openUC2/UC2-Hi2/IMAGES/Main.jpg

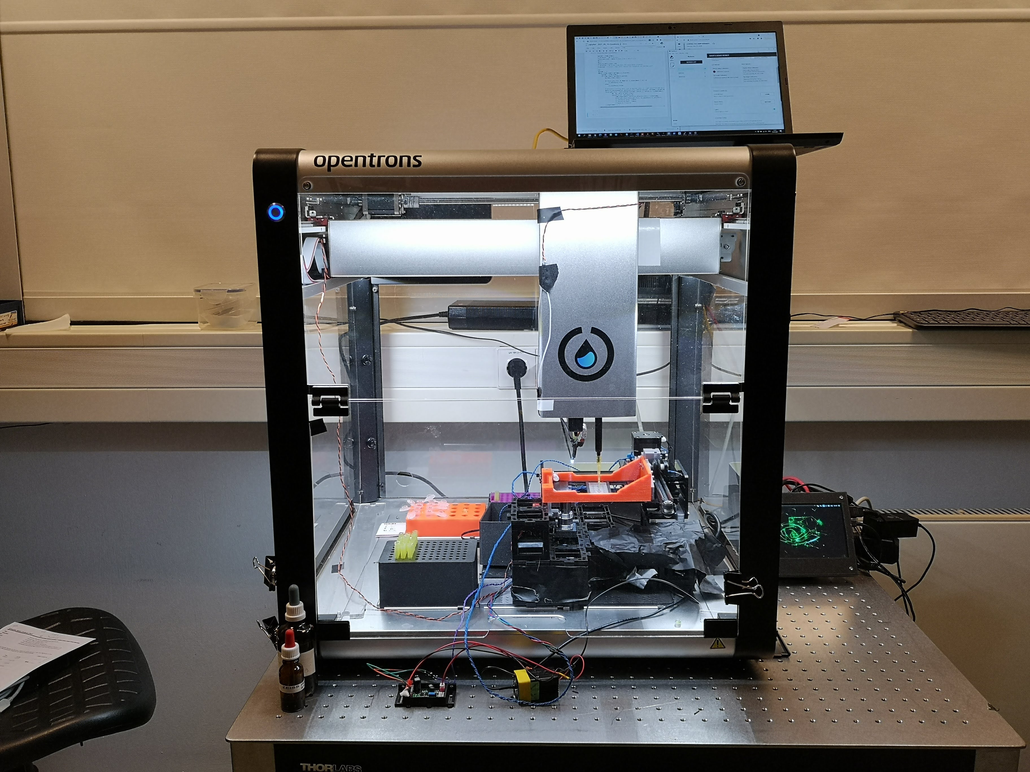
IMAGES/Main.jpg
