openUC2/UC2-Hi2/IMAGES/xyzstage.PNG

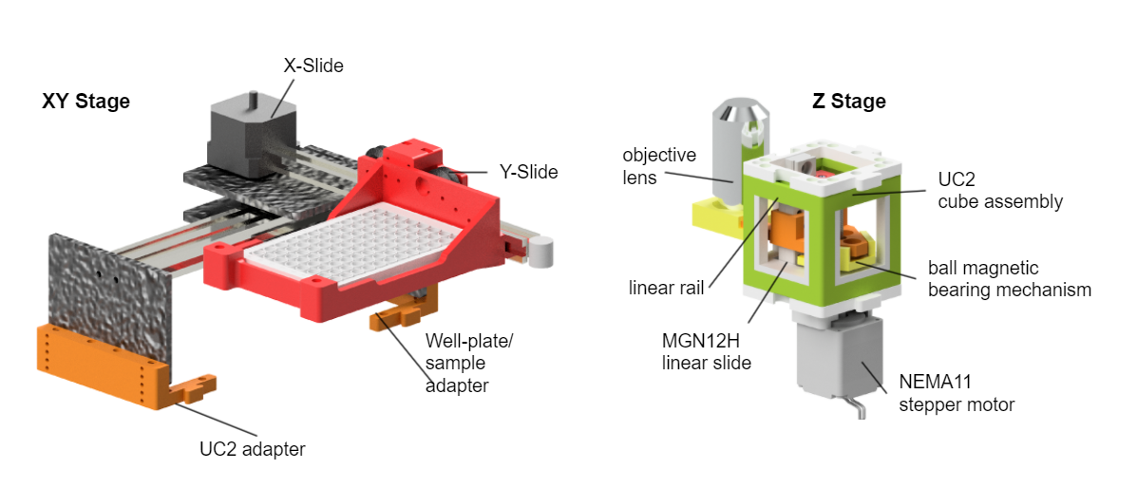
IMAGES/xyzstage.PNG
