openUC2/UC2-Hi2/UC2_Microscope_BillOfMaterial_Hi2.xlsx

Rough Price for one high-throughput microscope (without Laptop)
Shop | Name | URL | Amount | Price | Final Price
Robotershop | 4× 0,5 Meter Aluprofil 20x20 I-Typ Nut 59,40 €* (https://www.roboter-bausatz.de/p/0-5-meter-aluprofil-20x20-i-typ-nut-5) |  | 4 | 4.7 | 9.4
 | 2× Wantai Nema 17 Schrittmotor 40mm 1.7A 42BYGHW609X126,90 €* (https://www.roboter-bausatz.de/p/nema-17-schrittmotor-48mm) |  | 2 | 13 | 26
 | 1× 10 Meter GT2 Zahnriemen offen 6mm10,40 €* (https://www.roboter-bausatz.de/p/10-meter-gt2-zahnriemen-offen-6mm) |  | 1 | 5.2 | 10.4
 | 2× Riemenscheibe GT2 20 Zähne 8mm Bohrung für 6mm Riemen2,90 €* (https://www.roboter-bausatz.de/p/riemenscheibe-gt2-20-zaehne-8mm-bohrung-fuer-6mm-riemen) |  | 2 | 1.45 | 2.9
 | 6× V-Slot Führungsrolle mit Kugellager8,10 €* (https://www.roboter-bausatz.de/p/v-slot-fuehrungsrolle-mit-kugellager) |  | 6 | 4.05 | 8.1
 | 1× MKS DLC CNC / Lasergravierer Mainboard GRBL24,95 €* (https://www.roboter-bausatz.de/p/mks-dlc-cnc-lasergravierer-mainboard-grbl) |  | 1 | 12.475 | 24.95
 | 4× A4988 Schrittmotorentreiber5,00 €* (https://www.roboter-bausatz.de/p/a4988-schrittmotorentreiber) |  | 4 | 2.5 | 5
 | 1× yourDroid Netzteil 12V 3A 5,5x2,1mm DC-Stecker9,95 €* (https://www.roboter-bausatz.de/p/yourdroid-netzteil-12v-3a-5-5x2-1mm-dc-stecker) |  | 1 | 4.975 | 9.95
 | 1× Glasfaser LWL ST 12fach Pigtails farbig 9/125µ OS2 (G652.D) 1m0,99 €* (https://www.roboter-bausatz.de/p/glasfaser-lwl-st-12fach-pigtails-farbig-9-125-os2-g652.d-1m) |  | 1 | 0.5 | 1
 | 1× 50 MicroSchalter / Drucktaster 6x6x6mm0,85 €* (https://www.roboter-bausatz.de/p/50-microschalter-drucktaster-6x6x6mm) |  | 1 | 0.425 | 0.85
 | 1× 2 Pin Dupont / Jumper Kabel Buchse-Buchse 70 cm0,45 €* (https://www.roboter-bausatz.de/p/2-pin-dupont-jumper-kabel-buchse-buchse-70-cm) |  | 1 | 0.225 | 0.45
 | 1× 10er Set Befestigungsschrauben Winkel 30 I-Typ DIN 7380 M6x121,86 €* (https://www.roboter-bausatz.de/p/10er-set-befestigungsschrauben-winkel-30-i-typ-din-7380-m6x12) |  | 1 | 0.93 | 1.86
 | MGN12H Linearlager | https://www.roboter-bausatz.de/p/mgn12h-linearlager?sPartner=8 | 1 | 10 | 10
 | Linearführung MGN12H 450mm, 50mm (https://www.roboter-bausatz.de/p/linearfuehrung-mgn12h-450mm) | https://www.roboter-bausatz.de/p/linearfuehrung-mgn12h-450mm | 1 | 30 | 30
Edmund Optics | Allied Vision Alvium USB 3.1 Kamera 1800 U-158m, 1/2,9", 1,58 MP, C-Mount, monochrom (https://www.edmundoptics.de/p/allied-vision-alvium-1800-u-158m-129-158mp-c-mount-usb-31-monochrome-camera/44757/) |  | 1 | 330 | 330
 | 25,4 mm Durchm., Enhanced Aluminium, 4-6 λ Oberflächenspiegel (https://www.edmundoptics.de/p/254mm-dia-enhanced-aluminum-4-6lambda-mirror/26562/) |  | 3 | 21 | 63
 | 6mm Durchmesser x 30mm Länge, M3 Gewinde, Cage-System Stange (https://www.edmundoptics.de/p/6mm-diameter-x-30mm-length-m3-cage-support-rod/28337/) |  | 4 | 11.5 | 46
 | 25,4 mm D. x 88,9 mm Brennweite, VIS 0°-beschichtet, Achromat (https://www.edmundoptics.de/p/254mm-dia-x-889mm-fl-vis-0deg-coated-achromatic-lens/10243/) |  | 1 | 96 | 96
 | 500nm, 25mm Durchmesser, Langpassfilter OD 2 Lager #47-616 |  | 1 | 91 | 91
 | 550nm, 25mm Durchmesser, Langpassfilter OD 2 Lager #47-617 |  | 1 | 130 | 130
 | 650nm, 25mm Durchmesser, Langpassfilter OD 2 Lager #47-619 |  | 1 | 91 | 91
Optik-Pro | Optika Objektiv IOS LWD W-PLAN POL objective 20x/0.40, M-1138 | https://www.optik-pro.de/fuer-mikroskope/optika-objektiv-ios-lwd-w-plan-pol-objective-20x-0-40-m-1138/p,66005 | 0 | 168 | 0
 | Euromex Objektiv IS.7220, 20x/0.40, PLi, plan, infinity (iScope) | https://www.optik-pro.de/fuer-mikroskope/euromex-objektiv-is-7220-20x-0-40-pli-plan-infinity-iscope-/p,53372 | 0 | 159 | 0
 | Motic Objektiv CCIS plan achromat. EC-H PL 20x/0.45 (AA=0.9mm) | https://www.optik-pro.de/fuer-mikroskope/motic-objektiv-ccis-plan-achromat-ec-h-pl-20x-0-45-aa-0-9mm-/p,45909 | 0 | 169 | 0
 | Motic Objektiv EC PL, CCIS, plan, achro, NGC 20x/0.45 w.d. 1mm (BA-310 Elite) | https://www.optik-pro.de/fuer-mikroskope/motic-objektiv-ec-pl-ccis-plan-achro-ngc-20x-0-45-w-d-1mm-ba-310-elite-/p,57139 | 1 | 113 | 113
 | Windaus Objektiv 10x für HPM 100er Modelle | https://www.optik-pro.de/fuer-mikroskope/windaus-objektiv-10x-fuer-hpm-100er-modelle/p,7108 | 1 | 32 | 32
Prusa | Original Prusa Prusament PETG Galaxie Schwarz 1,75 mm 1.000 g | https://www.igo3d.com/original-prusa-prusament-petg-filament_8 | 1 | 30 | 30
Laserlands.net | 500mW RGB White Combined Laser Module Fat Beam | https://www.laserlands.net/diode-laser-module/rgb-combined-white-laser-module/11010016.html | 1 | 59.8 | 59.8
Thorlabs | F6SS088- ( Gesamtgewicht):0.01 Kgs, Fine Hex Adjuster, 6-80, 0.88" Long |  | 3 | 7.54 € | 22.62
 | F6SSN1P- ( Gesamtgewicht):0.01 Kgs, Threaded Bushing, Phosphor Bronze, 6-80, 0.25" Long |  | 3 | 4.82 € | 14.46
Misc | Screws |  | 1 | 25 | 25
 | LED (Brightfield) |  | 1 | 20 | 20
UC2 | 45° Mirror |  | 1
 | 45° mirror, kinematic |  | 2
 | Camera |  | 1
 | Filtercube |  | 1
 |  |  | 1
 | Empty |  | 12
 | Cubes total |  | 18 | 15 | 270
 | Baseplates |  | 36 | 10 | 360
 | Working Hours? |  | 10 | 50 | 500
 | Missing Things |  | 1 | 200 | 200
 |  |  |  | TOTAL: | 2634.74
