openUC2/UC2-Hi2/STL/Application_UC2_Hi2_Uppsala_v3_20_Cube_Insert_Kinematic_Mirrormount_45_base_part1_129.stl

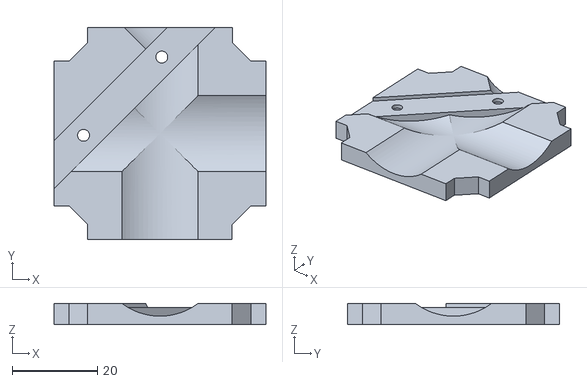
[picture p19: CAD file, 2021-12-19]
STL/Application_UC2_Hi2_Uppsala_v3_20_Cube_Insert_Kinematic_Mirrormount_45_base_part1_129.stl
49.8 x 49.8 x 5.00
