openUC2/UC2-Hi2/STL/Application_UC2_Hi2_Uppsala_v3_30_Cube_Z_Focus_Drylin_NEMA_slide_part1_70.stl

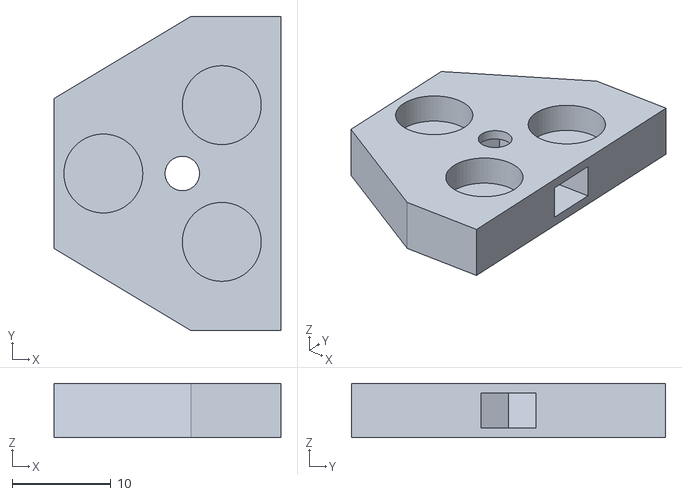
[picture p20: CAD file, 2021-12-19]
STL/Application_UC2_Hi2_Uppsala_v3_30_Cube_Z_Focus_Drylin_NEMA_slide_part1_70.stl
23.0 x 31.9 x 5.50
