openUC2/UC2-Hi2/STL/Application_UC2_Hi2_Uppsala_v3_Neje_puzzle_adapterplate_v3_21.stl

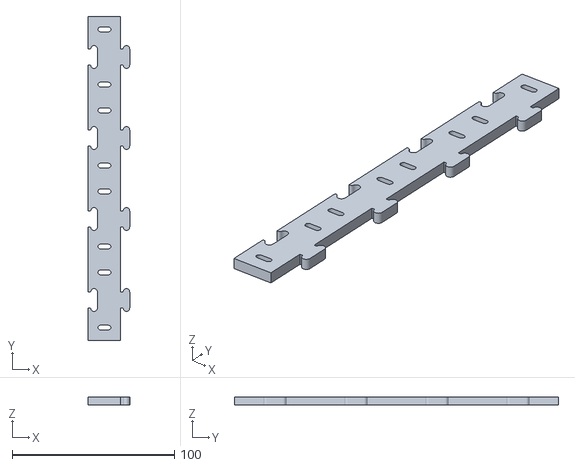
[picture p21: CAD file, 2021-12-19]
STL/Application_UC2_Hi2_Uppsala_v3_Neje_puzzle_adapterplate_v3_21.stl
25.6 x 200.0 x 5.00
