openUC2/UC2-Hi2/STL/Application_UC2_Hi2_Uppsala_v3_TOTEM_Base_Slide_y_20mmrod_7.stl

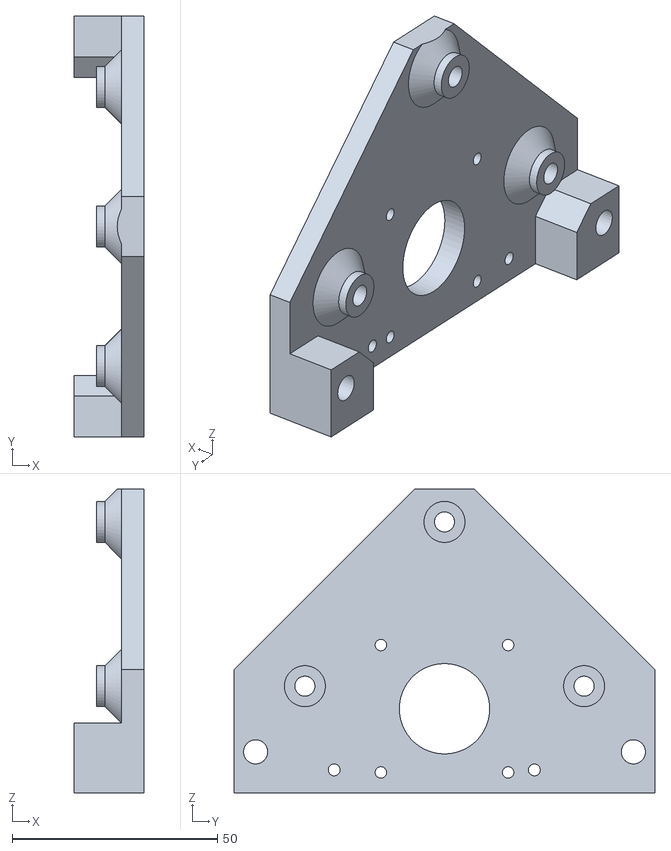
[picture p22: CAD file, 2021-12-19]
STL/Application_UC2_Hi2_Uppsala_v3_TOTEM_Base_Slide_y_20mmrod_7.stl
17.0 x 102.5 x 74.0
