openUC2/UC2-Hi2/STL/Application_UC2_Hi2_Uppsala_v3_20_Cube_Insert_Lens_165mm_36.stl

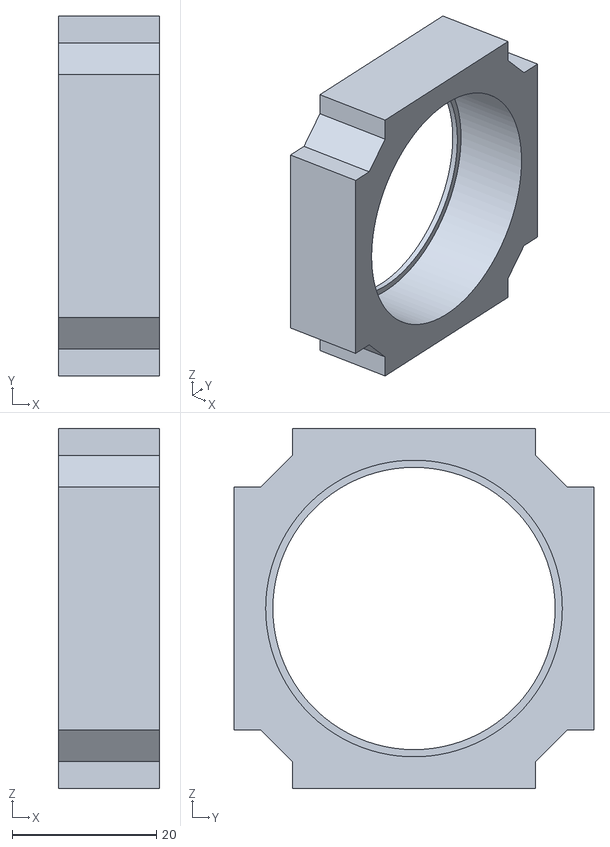
[picture p23: CAD file, 2021-12-19]
STL/Application_UC2_Hi2_Uppsala_v3_20_Cube_Insert_Lens_165mm_36.stl
14.0 x 50.0 x 50.0
