openUC2/UC2-Hi2/STL/Application_UC2_Hi2_Uppsala_v3_30_Cube_Z_Focus_MGN_NEMA_Motorsupport_73.stl

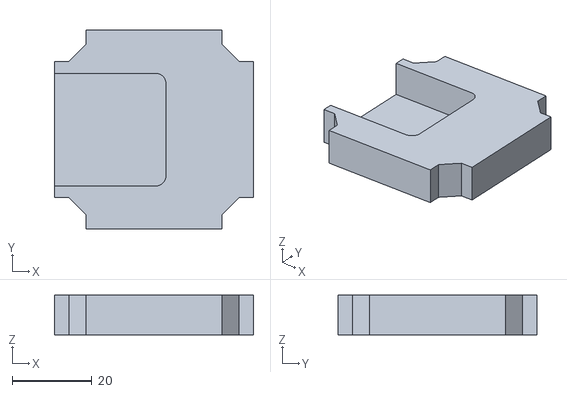
[picture p24: CAD file, 2021-12-19]
STL/Application_UC2_Hi2_Uppsala_v3_30_Cube_Z_Focus_MGN_NEMA_Motorsupport_73.stl
49.8 x 49.8 x 10.0
