openUC2/UC2-Hi2/STL/Application_UC2_Hi2_Uppsala_v3_30_Cube_Z_Focus_MGN_NEMA_Motoradapter_28BYJ_v3_72.stl

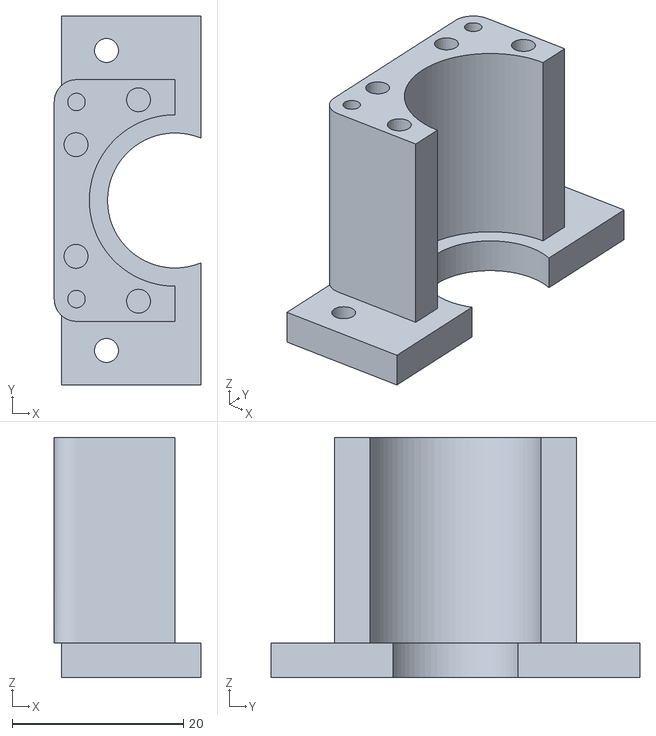
[picture p25: CAD file, 2021-12-19]
STL/Application_UC2_Hi2_Uppsala_v3_30_Cube_Z_Focus_MGN_NEMA_Motoradapter_28BYJ_v3_72.stl
17.1 x 43.0 x 28.0
