openUC2/UC2-Hi2/STL/Application_UC2_Hi2_Uppsala_v3_30_Cube_Z_Focus_MGN_NEMA_counterplate_82.stl

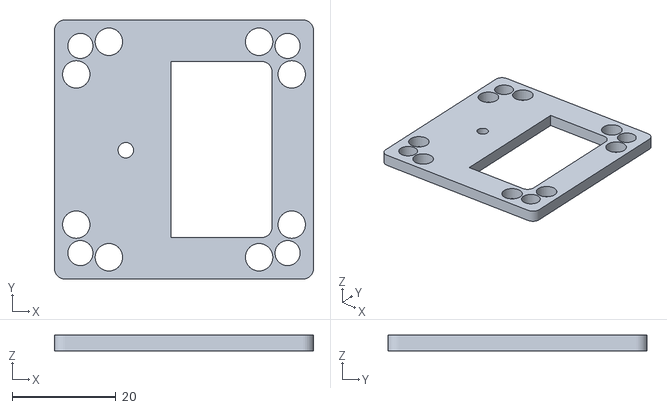
[picture p26: CAD file, 2021-12-19]
STL/Application_UC2_Hi2_Uppsala_v3_30_Cube_Z_Focus_MGN_NEMA_counterplate_82.stl
50.0 x 50.0 x 3.00
