openUC2/UC2-Hi2/STL/Application_UC2_Hi2_Uppsala_v3_20_Cube_Insert_Lens_165mm_clamp_37.stl

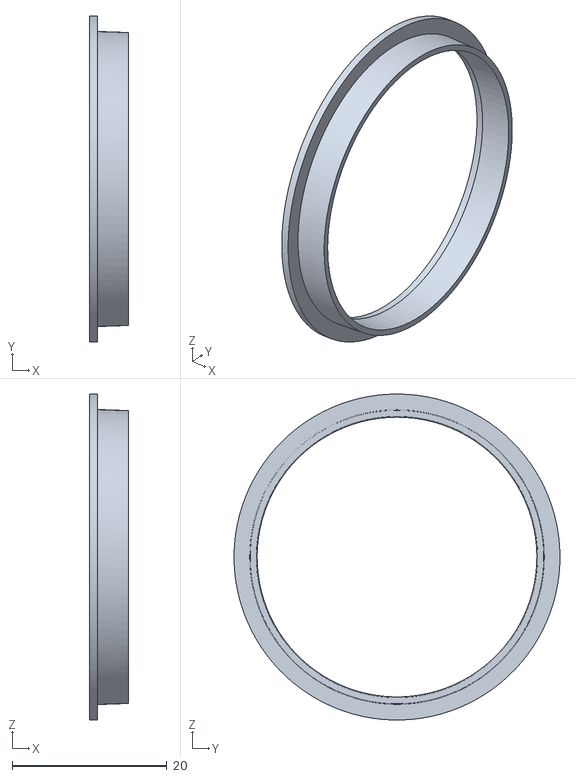
[picture p27: CAD file, 2021-12-19]
STL/Application_UC2_Hi2_Uppsala_v3_20_Cube_Insert_Lens_165mm_clamp_37.stl
5.00 x 42.2 x 42.2
