openUC2/UC2-Hi2/STL/Application_UC2_Hi2_Uppsala_v3_20_Cube_insert_Laser_Block_adjustable_v3_42.stl

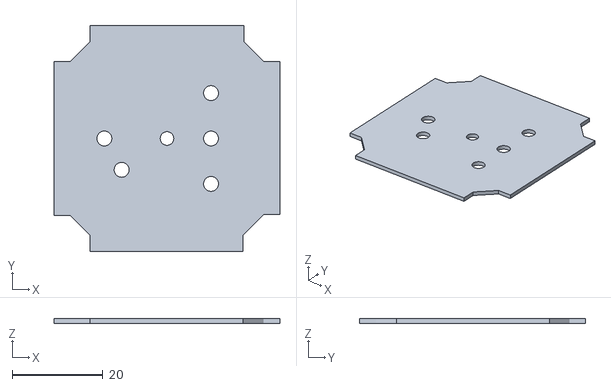
[picture p28: CAD file, 2021-12-19]
STL/Application_UC2_Hi2_Uppsala_v3_20_Cube_insert_Laser_Block_adjustable_v3_42.stl
49.8 x 49.8 x 1.00
