openUC2/UC2-Hi2/STL/Application_UC2_Hi2_Uppsala_v3_30_Cube_Z_Focus_MGN_NEMA_adapter_RMS_67.stl

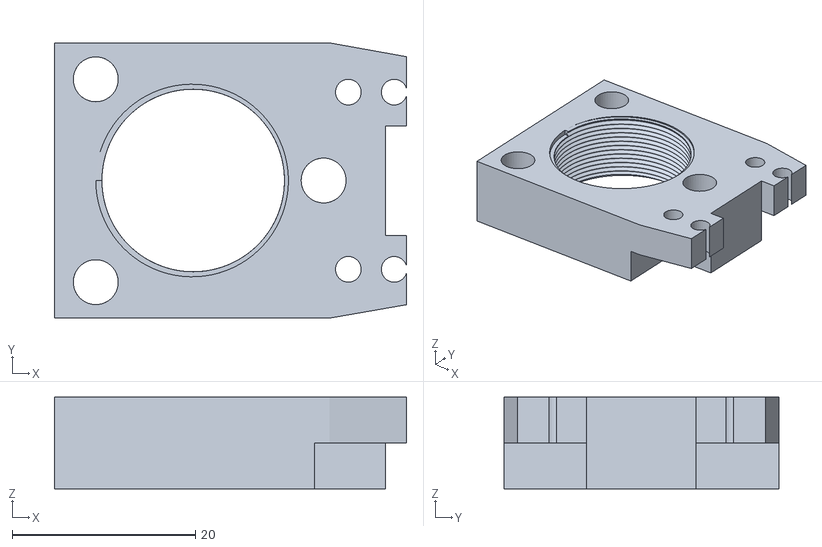
[picture p29: CAD file, 2021-12-19]
STL/Application_UC2_Hi2_Uppsala_v3_30_Cube_Z_Focus_MGN_NEMA_adapter_RMS_67.stl
38.4 x 30.0 x 10.0
