openUC2/UC2-Hi2/STL/Application_UC2_Hi2_Uppsala_v3_Neje_Base_Slide_y_stop_9.stl

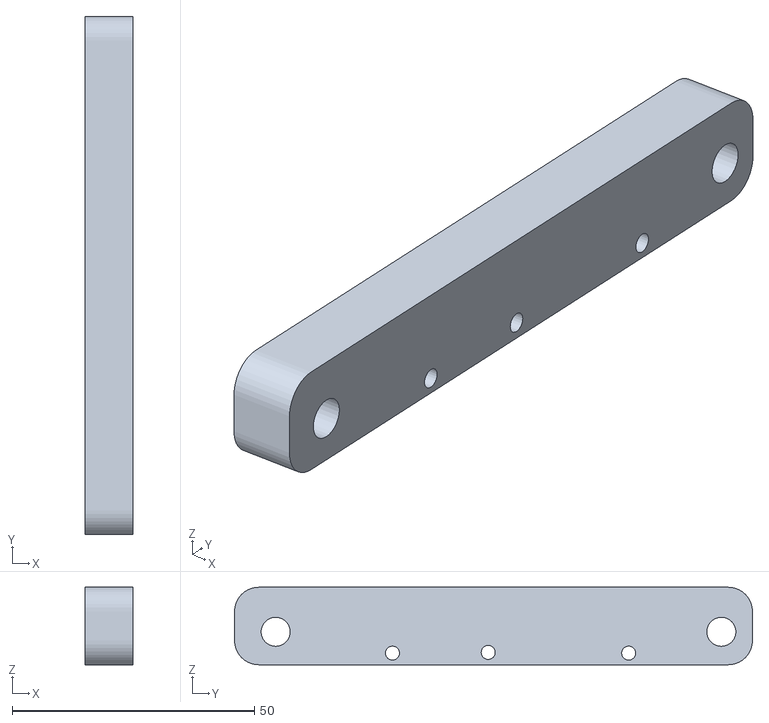
[picture p30: CAD file, 2021-12-19]
STL/Application_UC2_Hi2_Uppsala_v3_Neje_Base_Slide_y_stop_9.stl
10.0 x 106.9 x 16.0
