openUC2/UC2-Hi2/STL/Application_UC2_Hi2_Uppsala_v3_30_Cube_Z_Focus_MGN_NEMA_Motoradapter_NEMA11_v3_71.stl

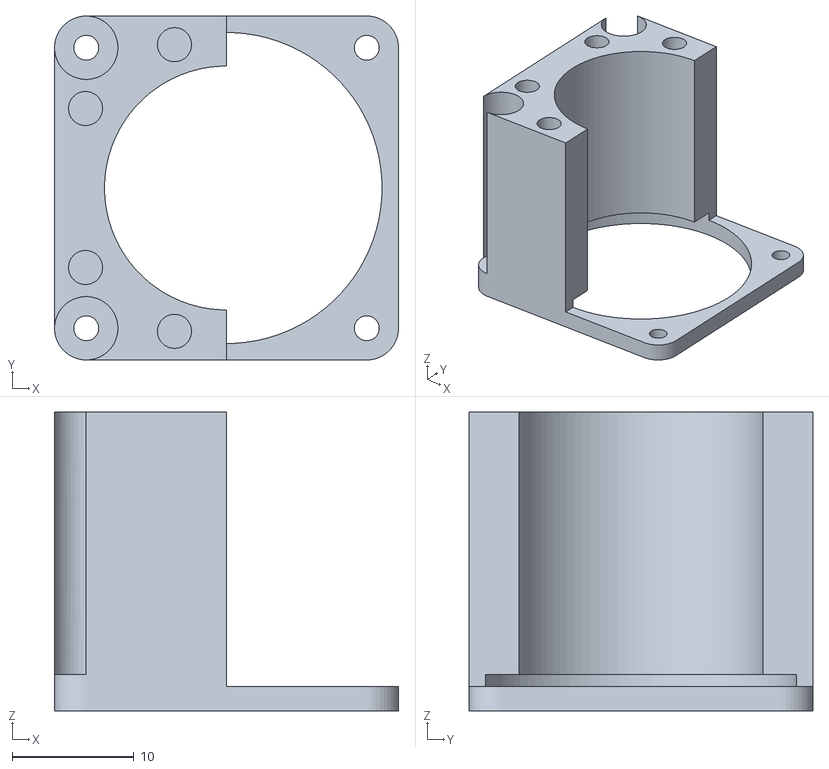
[picture p31: CAD file, 2021-12-19]
STL/Application_UC2_Hi2_Uppsala_v3_30_Cube_Z_Focus_MGN_NEMA_Motoradapter_NEMA11_v3_71.stl
28.2 x 28.2 x 24.5
