openUC2/UC2-Hi2/STL/Application_UC2_Hi2_Uppsala_v3_10_Base_puzzle_v3_101.stl

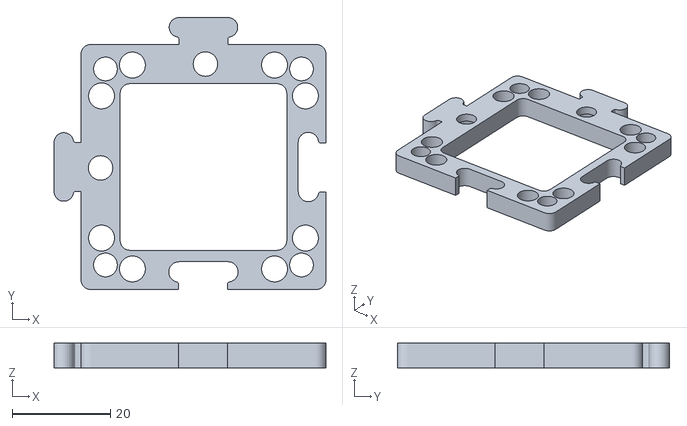
[picture p33: CAD file, 2021-12-19]
STL/Application_UC2_Hi2_Uppsala_v3_10_Base_puzzle_v3_101.stl
55.5 x 55.5 x 5.00
