openUC2/UC2-Hi2/STL/Application_UC2_Hi2_Uppsala_v3_20_Cube_Insert_Kinematic_Mirrormount_45_base_part2_130.stl

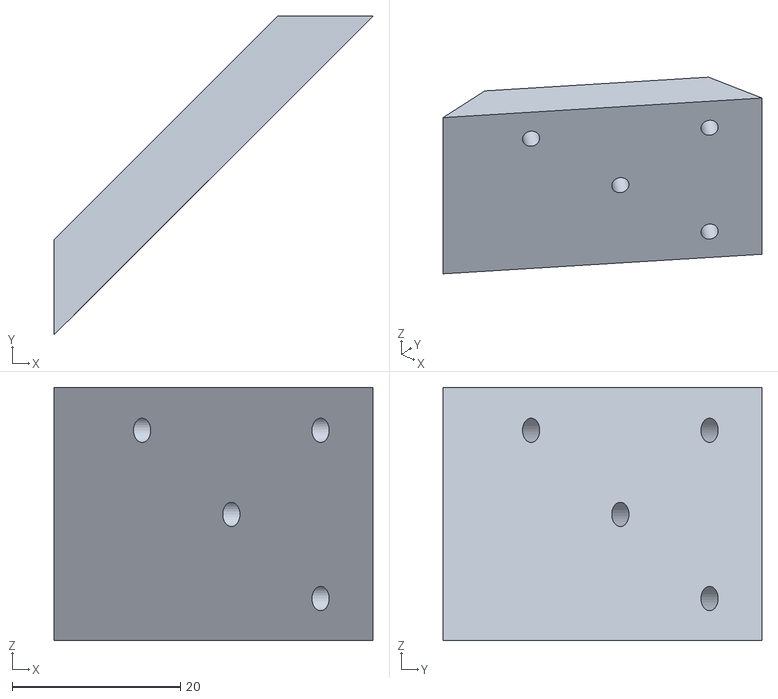
[picture p34: CAD file, 2021-12-19]
STL/Application_UC2_Hi2_Uppsala_v3_20_Cube_Insert_Kinematic_Mirrormount_45_base_part2_130.stl
37.9 x 37.9 x 30.1
