openUC2/UC2-Hi2/STL/Application_UC2_Hi2_Uppsala_v3_20_Cube_insert_AlliedVision_Alvium_v3_41.stl

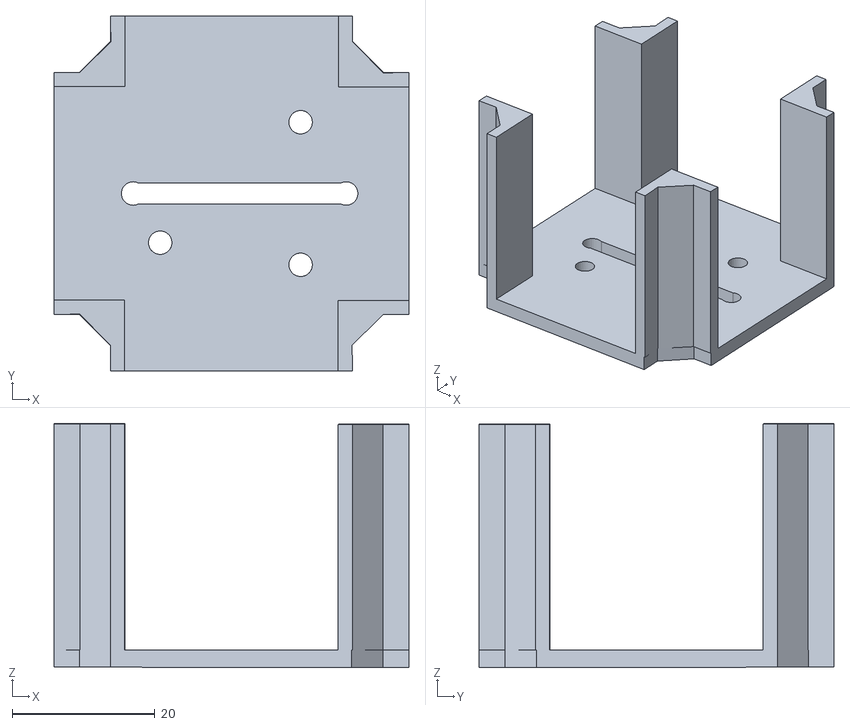
[picture p35: CAD file, 2021-12-19]
STL/Application_UC2_Hi2_Uppsala_v3_20_Cube_insert_AlliedVision_Alvium_v3_41.stl
49.8 x 49.8 x 34.3
