openUC2/UC2-Hi2/STL/Application_UC2_Hi2_Uppsala_v3_30_Cube_Z_Focus_MGN12_NEMA_slide_part2_66.stl

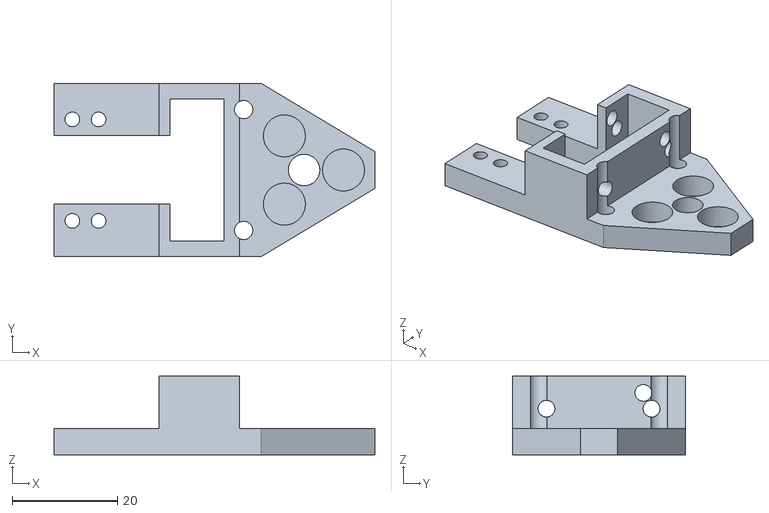
[picture p36: CAD file, 2021-12-19]
STL/Application_UC2_Hi2_Uppsala_v3_30_Cube_Z_Focus_MGN12_NEMA_slide_part2_66.stl
61.1 x 33.0 x 15.0
