openUC2/UC2-Hi2/STL/Application_UC2_Hi2_Uppsala_v3_TOTEM_Base_Slide_x_20mmrod_23.stl

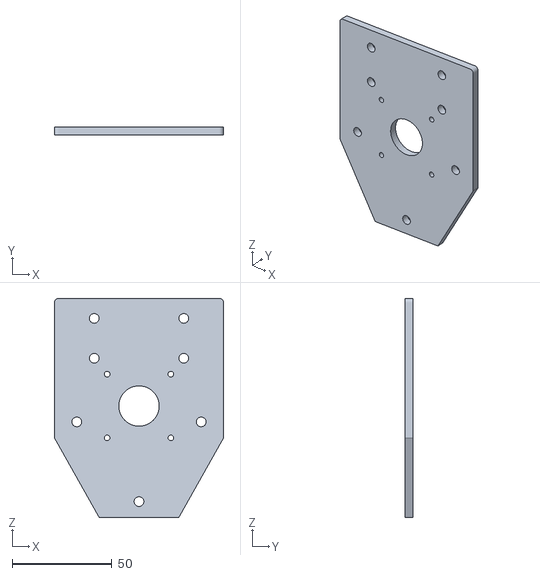
[picture p37: CAD file, 2021-12-19]
STL/Application_UC2_Hi2_Uppsala_v3_TOTEM_Base_Slide_x_20mmrod_23.stl
85.0 x 4.00 x 110.0
