openUC2/UC2-Hi2/STL/30_Cube_Insert_Filter_Revolver_Filter_base_single_v3.stl

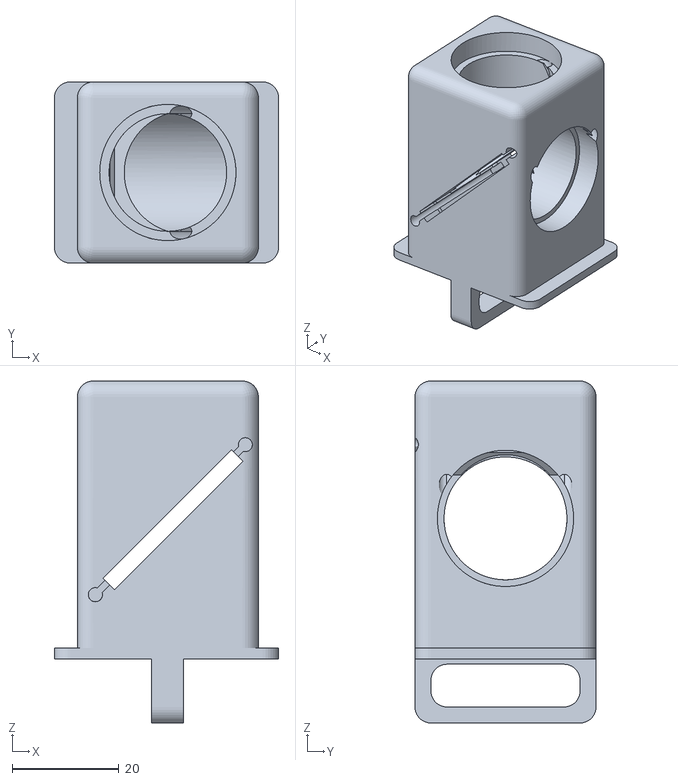
[picture p38: CAD file, 2021-12-19]
STL/30_Cube_Insert_Filter_Revolver_Filter_base_single_v3.stl
42.0 x 33.9 x 64.0
