openUC2/UC2-Hi2/STL/Application_UC2_Hi2_Uppsala_v3_10_Cube_1x1_IM_128.stl

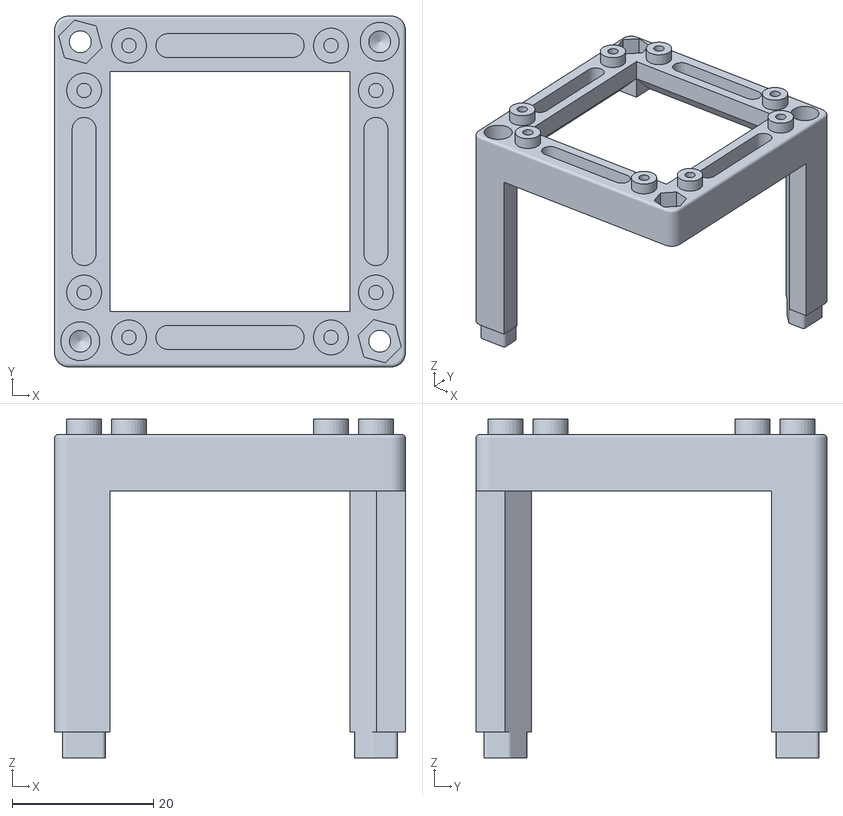
[picture p39: CAD file, 2021-12-19]
STL/Application_UC2_Hi2_Uppsala_v3_10_Cube_1x1_IM_128.stl
49.7 x 49.7 x 48.0
