openUC2/UC2-Hi2/(list of files, cad)

Other CAD files:
INVENTOR/Templates/English/ANSI (in).dwg
INVENTOR/Templates/Metric/JIS.dwg
INVENTOR/Templates/Standard.dwg
INVENTOR/Templates/Metric/BSI.dwg
INVENTOR/Templates/Metric/ISO.dwg
INVENTOR/Templates/Metric/ANSI (mm).dwg
INVENTOR/Templates/Metric/GOST.dwg
INVENTOR/Templates/Metric/DIN.dwg
STL/Application_UC2_Hi2_Uppsala_v3_20_Cube_Insert_Kinematic_Mirrormount_45_base_part1_45.stl
INVENTOR/Templates/Metric/GB.dwg
STL/Application_UC2_Hi2_Uppsala_v3_TOTEM_Base_Slide_y_20mmrod_6.stl
STL/Application_UC2_Hi2_Uppsala_v3_20_Cube_insert_AlliedVision_Alvium_v3_33.stl
STL/Application_UC2_Hi2_Uppsala_v3_Neje_puzzle_adapterplate_v3_20.stl
STL/Application_UC2_Hi2_Uppsala_v3_TOTEM_Base_Slide_x_20mmrod_1.stl
STL/Application_UC2_Hi2_Uppsala_v3_20_Cube_Insert_Kinematic_Mirrormount_45_base_part2_46.stl
INVENTOR/00_Aluminiumrail_nutslider_block.ipt
INVENTOR/00_BallMagnets_5mm_single.ipt
INVENTOR/00_Chroma_Dichroic_25x,3x1.ipt
INVENTOR/00_Comar_Filter_25Dia.ipt
INVENTOR/00_Gear_Pulley_GT2_nut.ipt
INVENTOR/00_Joy-IT-B20SHD4353_NEMA8_captive.ipt
INVENTOR/00_Laser_532nm_200mw.ipt
INVENTOR/00_MGN12H, LINEAR GUIDE BLOCK.ipt
INVENTOR/00_Microscope_Objective_Lens10x.ipt
INVENTOR/00_Motorcoupling_5mm_M3.ipt
INVENTOR/00_NEMA11.ipt
INVENTOR/00_NEMA17.ipt
INVENTOR/00_RS_Pro_Micrometer_small.ipt
INVENTOR/00_Spacer_13mm.ipt
INVENTOR/00_Stepper_Motor_28BYJ-48.ipt
INVENTOR/00_Thorlabs_Cage_CP33_M.ipt
INVENTOR/00_Thorlabs_PF10-03-P01-Step.ipt
INVENTOR/00_Thorlabs_Rod_6mm.ipt
INVENTOR/00_V-Slot_20x.ipt
INVENTOR/00_VSlot_20mm_200mm.ipt
INVENTOR/00_VSlot_20mm_250mm.ipt
INVENTOR/00_VSlot_90degree_bracket.ipt
INVENTOR/00_bearing_ball_2mm.ipt
INVENTOR/00_coupler_5_3_nema_screw.ipt
INVENTOR/00_coupler_5_3_nema_screw_nut.ipt
INVENTOR/10_Base_puzzle_v3.ipt
INVENTOR/10_Cube_1x1_IM.ipt
INVENTOR/20_Cube_Insert_Beamsplittercube_Base_25x35_v3.ipt
INVENTOR/20_Cube_Insert_Beamsplittercube_Dichroicmirror_Retainplate_25_36.ipt
INVENTOR/20_Cube_Insert_Beamsplittercube_Retainring_25mm.ipt
INVENTOR/20_Cube_Insert_Kinematic_Mirrormount_45_Thorlabsadapter.ipt
INVENTOR/20_Cube_Insert_Kinematic_Mirrormount_45_base_part1.ipt
INVENTOR/20_Cube_Insert_Kinematic_Mirrormount_45_base_part2.ipt
INVENTOR/20_Cube_Insert_Lens_165mm.ipt
INVENTOR/20_Cube_Insert_Lens_165mm_clamp.ipt
INVENTOR/20_Cube_Insert_Mirror_Holder_Thorlabs_v3.ipt
INVENTOR/20_Cube_Insert_Mirror_Holder_wLogo_v3.ipt
INVENTOR/20_Cube_insert_AlliedVision_Alvium_v3.ipt
INVENTOR/20_Cube_insert_Laser_Block_adjustable_v3.ipt
INVENTOR/20_Insert_Thorlabs_holder_v3.ipt
INVENTOR/30_Adapter_M3_nut.ipt
INVENTOR/30_Coupling_Screw_28BYJ_M3.ipt
INVENTOR/30_Cube_Cube_Z_Focus_NEMA8_captive_objectivemount_v0.ipt
INVENTOR/30_Cube_Z_Focus_Drylin_NEMA_slide_part1.ipt
INVENTOR/30_Cube_Z_Focus_MGN12_NEMA_slide_part2.ipt
INVENTOR/30_Cube_Z_Focus_MGN_NEMA_Motoradapter_28BYJ_v3.ipt
INVENTOR/30_Cube_Z_Focus_MGN_NEMA_Motoradapter_NEMA11_v3.ipt
INVENTOR/30_Cube_Z_Focus_MGN_NEMA_Motorsupport.ipt
INVENTOR/30_Cube_Z_Focus_MGN_NEMA_adapter_RMS.ipt
INVENTOR/30_Cube_Z_Focus_MGN_NEMA_base_v3.ipt
INVENTOR/30_Cube_Z_Focus_MGN_NEMA_counterplate.ipt
INVENTOR/30_Cube_Z_Focus_MGN_NEMA_rail.ipt
INVENTOR/30_Cube_Z_Focus_NEMA8_captive_base_v0.ipt
INVENTOR/30_Cube_Z_Focus_NEMA8_captive_micrometerscrewbase_v0.ipt
INVENTOR/30_Cube_Z_Focus_NEMA8_captive_motorbase_v0.ipt
INVENTOR/Application_UC2_Hi2_Creality CV-01 PRO_v3.iam
INVENTOR/Assembly_Cube_AlliedVision_Alvium_v3.iam
INVENTOR/Assembly_Cube_Dichroic_Beamsplitter_25x35_v3.iam
INVENTOR/Assembly_Cube_Kinematic_Mirrormount_Thorlabs_45_v3.iam
INVENTOR/Assembly_Cube_Laser_Block_v3.iam
INVENTOR/Assembly_Cube_Lens_holder_165mm_v3.iam
INVENTOR/Assembly_Cube_Mirror_Thorlabs_v3.iam
INVENTOR/Assembly_Cube_Thorlabs_Cage_v3.iam
INVENTOR/Assembly_Cube_Z-Stage_NEMA8_captive_v0.iam
INVENTOR/Assembly_Cube_Z_Focus_MGN_NEMA_v3.iam
INVENTOR/Assembly_Cube_empty_IM_v3.iam
INVENTOR/Assembly_Insert_Kinematic_Mirrormount_45_base.iam
INVENTOR/Assembly_Motorcoupling_Nema_M3_Selfcentering.iam
INVENTOR/Assembly_TOTEM_XY_Hi2_Module.iam
INVENTOR/Assembly_neje_slide_plate.iam
INVENTOR/Assembly_neje_slide_y_20mmrod.iam
INVENTOR/Assembly_neje_slide_y_wellplateholder_20mmrod.iam
INVENTOR/DIN 912 - M3 x 0,5 x 12 x 10,75.ipt
INVENTOR/Design Data/AIT/Mold Design/mold design stop pin.ipt
INVENTOR/Design Data/Cable & Harness/de-DE/harness.iam
INVENTOR/Design Data/Cable & Harness/en-US/harness.iam
INVENTOR/Design Data/Tube & Pipe/de-DE/piping runs.iam
INVENTOR/Design Data/Tube & Pipe/en-US/piping runs.iam
INVENTOR/Neje_20mm_rod_connector_double.ipt
INVENTOR/Neje_20mm_rod_connector_double_R1.ipt
INVENTOR/Neje_Base_Rod_20mm.ipt
INVENTOR/Neje_Base_Rod_20mmX200mm.ipt
INVENTOR/Neje_Base_Rod_double_20mm.ipt
INVENTOR/Neje_Base_Slide_y_20mmrod.ipt
INVENTOR/Neje_Base_Slide_y_20mmrod_R11.ipt
INVENTOR/Neje_Base_Slide_y_stop.ipt
INVENTOR/Neje_Endrole_Adapter.ipt
INVENTOR/Neje_Rolls.ipt
INVENTOR/Neje_Rolls_small.ipt
INVENTOR/Neje_distancering.ipt
INVENTOR/Neje_puzzle_adapterplate_v3.ipt
INVENTOR/Neje_slide_y_20mmrod_lowerplate.ipt
INVENTOR/Neje_slide_y_20mmrod_upperplate.ipt
INVENTOR/OldVersions/00_Spacer_13mm.0005.ipt
INVENTOR/OldVersions/Assembly_Cube_Laser_Block_v3.0019.iam
INVENTOR/OldVersions/Assembly_Cube_Z_Focus_MGN_NEMA_v3.0065.iam
INVENTOR/OldVersions/Assembly_neje_slide_plate.0032.iam
INVENTOR/OldVersions/Assembly_neje_slide_y_wellplateholder_20mmrod.0047.iam
INVENTOR/OldVersions/Neje_Endrole_Adapter.0004.ipt
INVENTOR/OldVersions/Neje_distancering.0002.ipt
INVENTOR/TOTEM_Base_Slide_x_20mmrod.ipt
INVENTOR/TOTEM_Base_Slide_y_20mmrod.ipt
INVENTOR/TOTEM_Slider_X.iam
INVENTOR/TOTEM_Slider_Y.iam
INVENTOR/Templates/English/ANSI (in).idw
INVENTOR/Templates/English/Mold Design (in).iam
INVENTOR/Templates/English/Sheet Metal (in).ipt
INVENTOR/Templates/English/Standard (in).iam
INVENTOR/Templates/English/Standard (in).ipn
INVENTOR/Templates/English/Standard (in).ipt
INVENTOR/Templates/English/Weldment (ANSI).iam
INVENTOR/Templates/Metric/ANSI (mm).idw
INVENTOR/Templates/Metric/BSI.idw
INVENTOR/Templates/Metric/DIN.idw
INVENTOR/Templates/Metric/GB.idw
INVENTOR/Templates/Metric/GOST.idw
INVENTOR/Templates/Metric/ISO.idw
INVENTOR/Templates/Metric/JIS.idw
INVENTOR/Templates/Metric/Mold Design (DIN).iam
INVENTOR/Templates/Metric/Mold Design (mm).iam
INVENTOR/Templates/Metric/Sheet Metal (DIN).ipt
INVENTOR/Templates/Metric/Sheet Metal (mm).ipt
INVENTOR/Templates/Metric/Standard (DIN).iam
INVENTOR/Templates/Metric/Standard (DIN).ipn
INVENTOR/Templates/Metric/Standard (DIN).ipt
INVENTOR/Templates/Metric/Standard (mm).iam
INVENTOR/Templates/Metric/Standard (mm).ipn
INVENTOR/Templates/Metric/Standard (mm).ipt
INVENTOR/Templates/Metric/Weldment (ANSI - mm).iam
INVENTOR/Templates/Metric/Weldment (BSI).iam
INVENTOR/Templates/Metric/Weldment (DIN).iam
INVENTOR/Templates/Metric/Weldment (GB).iam
INVENTOR/Templates/Metric/Weldment (ISO).iam
INVENTOR/Templates/Metric/Weldment (JIS).iam
INVENTOR/Templates/Mold Design/Mold Design.iam
INVENTOR/Templates/Sheet Metal.ipt
INVENTOR/Templates/Standard.iam
INVENTOR/Templates/Standard.idw
INVENTOR/Templates/Standard.ipn
INVENTOR/Templates/Standard.ipt
INVENTOR/Templates/Weldment.iam
STL/Application_UC2_Hi2_Uppsala_v3_20_Cube_Insert_Kinematic_Mirrormount_45_Thorlabsadapter_140.stl
STL/Application_UC2_Hi2_Uppsala_v3_20_Cube_Insert_Kinematic_Mirrormount_45_Thorlabsadapter_56.stl
STL/Application_UC2_Hi2_Uppsala_v3_20_Cube_Insert_Mirror_Holder_Thorlabs_v3_62.stl
STL/Application_UC2_Hi2_Uppsala_v3_20_Insert_Thorlabs_holder_v3_126.stl
