openUC2/UC2-Hi2/(threads)

Thread 1 (2021-06-22):

Suggested improvements

b286, 2021-06-22:
It's awesome and super cool ❤️ ❤️ ❤️

I've went through it critically but there's not much to complain about. Let me know if I should just fix the typos, broken links and these things.

- [x] Add the short version of the UC2 repository header with link to the main one to keep the style of them alike
- [x] "Scroll to the very bottom of the page." suggests to skip most of the page. Confusing. Better: "Keep scrolling" or something
- [x] Opentrons OT2, Opentrons Website, CONTRIBUTING, Please find the type of licenses here - broken links
- [x] table of content doesn't appear as a list
- [x] typos: expdreiment, above one need (fullstop missing), Baser Camera, Prusmant, plate is only hold, Screws in the wholes, ~1 mm I would say. (comma missing)
- [x] add link: Nejetools.com
- [x] *The plate can easily adapt all kinds of samples* - add spacing, doesn't format
- [ ] Assembly of the XY Stage - the figure comes before the text related to it - this is confusing as our whole repository is done the other way around
- [x] Credits - no credits there, better say "Collaborate" or so
- [ ] README_SOFTWARE.md - the entry barrier to high but as you said it's still in development :)
- [ ] README_SOFTWARE.md - figure on the bottom doesn't show

beniroquai, 2021-06-22:
Thank you very much for making this project so much better :-P

I updated most of the points listed above! Thanks a lot!!

Closed 2021-06-22.

Thread 2 (2024-03-27):

Links don't work

jsmithe2, 2024-03-27:
I am trying to get Inventor files for the 3D parts needed for the multiwell plate holder but the links do not work and I cannot find the the similar file in the 'Inventor' tab. Can you direct me to where these 4 files would be located to make the well plate adapter and the needed parts to add it on the XY stage?

jsmithe2, 2024-03-27:
I figured it out right after. Thanks!

Closed 2024-03-27.

Thread 4 (2024-08-30):

Request for Inventor file- Well plate holder

jsmithe2, 2024-08-30:
@beniroquai For the multiwell plate holder STL file, the holes where the springs and level arm would insert into are not centered along the opening and does not allow the spring to work properly. I am not able to edit this on an STL file very effectively without redesigning the whole well plate holder. Would you be able to provide an ipt file (inventor file) for this part so I can edit it. I can send back the edited version afterward if you'd like.

jsmithe2, 2024-08-30:
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

beniroquai, 2024-08-31:
Hey @jsmithe2, are those files available in https://github.com/openUC2/UC2-Hi2/tree/master/INVENTOR by any chance? If you tell me the file's name, I can check on my computer.

beniroquai, 2024-09-03:
Thanks for your reply.  Did you actually try to migrate those files e.g. into Fusion360? Its free for non-commercial use.

I must admit that it's 3 years ago that I uploaded the files. There are better ways to build a device with a smilar set of functions now ;-)
