openUC2/UC2-Hi2/PYTHON/grbl/gpio_python.py

import RPi.GPIO as GPIO
import time

# Pin Definitions
output_pin = 18  # BCM pin 18, BOARD pin 12
output_gnd = 17
def main():
    # Pin Setup:
    GPIO.setmode(GPIO.BCM)  # BCM pin-numbering scheme from Raspberry Pi
    # set pin as an output pin with optional initial state of HIGH
    GPIO.setup(output_pin, GPIO.OUT, initial=GPIO.HIGH)
    GPIO.setup(output_gnd, GPIO.OUT, initial=GPIO.HIGH)

    print("Starting demo now! Press CTRL+C to exit")
    curr_value = GPIO.HIGH
    try:
        while True:
            time.sleep(1)
            # Toggle the output every second
            print("Outputting {} to pin {}".format(curr_value, output_pin))
            GPIO.output(output_pin, curr_value)
            GPIO.output(output_gnd, not curr_value)
            if curr_value == GPIO.HIGH:
                        GPIO.output(output_gnd, GPIO.LOW)
            
            curr_value ^= GPIO.HIGH
    finally:
        GPIO.cleanup()

if __name__ == '__main__':
    main()
