openUC2/UC2-Hi2/(commit log)

2021-06-10 Initial quick-and-dirty commit
    [00_MGN12H, LINEAR GUIDE BLOCK.ipt, 00_Microscope_Objective_Lens10x.ipt, 00_Mirror_30x30.ipt, 00_Motorcoupling_5mm_M3.ipt, 00_NEMA11.ipt, 00_NEMA_17.ipt, 00_RasPi_Camera.ipt, 00_bearing_ball_2mm.ipt]
2021-06-13 Update the documentation for the HI2 Module
    [Assembly_CUBE_XY_Stage_neje_laser_v3_01_MTP_96_wellplate_holder_part2.stl, Assembly_CUBE_XY_Stage_neje_laser_v3_30_Adapter_neje_to_cube_bd_v3.stl, Assembly_CUBE_XY_Stage_neje_laser_v3_30_Adapter_neje_to_cube_bd_v3_1.stl, Assembly_CUBE_XY_Stage_neje_laser_v3_30_MTP_wellplate_to_sample_adapter.stl, Assembly_CUBE_XY_Stage_neje_laser_v3_Neje_Support_Slider_Y.stl, Assembly_CUBE_XY_Stage_neje_laser_v3_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]
2021-08-22 Adding Bill of materials (BOM)
    [UC2_Microscope_BillOfMaterial_Hi2.xlsx]
2021-12-19 Updated to newest version (Uppsala) - documentation will follow
    [00_Aluminiumrail_nutslider_block.ipt, 00_BallMagnets_5mm_single.ipt, 00_Chroma_Dichroic_25x,3x1.ipt, 00_Comar_Filter_25Dia.ipt, 00_Gear_Pulley_GT2_nut.ipt, 00_Laser_532nm_200mw.ipt, 00_Mirror_30x30.ipt, 00_Motorcoupling_5mm_M3.ipt]
2022-07-26 updating CAD files
    [00_Joy-IT-B20SHD4353_NEMA8_captive.ipt, 00_RS_Pro_Micrometer_small.ipt, 00_Spacer_13mm.0005.ipt, 00_Spacer_13mm.ipt, 30_Cube_Cube_Z_Focus_NEMA8_captive_objectivemount_v0.ipt, 30_Cube_Z_Focus_NEMA8_captive_base_v0.ipt, 30_Cube_Z_Focus_NEMA8_captive_micrometerscrewbase_v0.ipt, 30_Cube_Z_Focus_NEMA8_captive_motorbase_v0.ipt]
